Eashanvi/AdaptiveSonar/Figures/Adaptive LFM Sonar Waveform(Deep).png

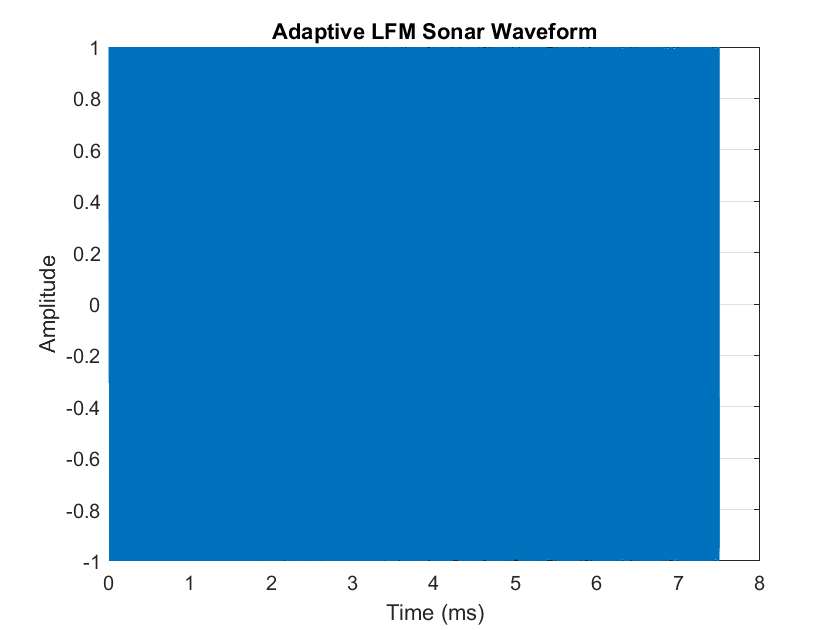
Figures/Adaptive LFM Sonar Waveform(Deep).png
