Eashanvi/AdaptiveSonar/Figures/Adaptive LFM Sonar Waveform(Moderate).png

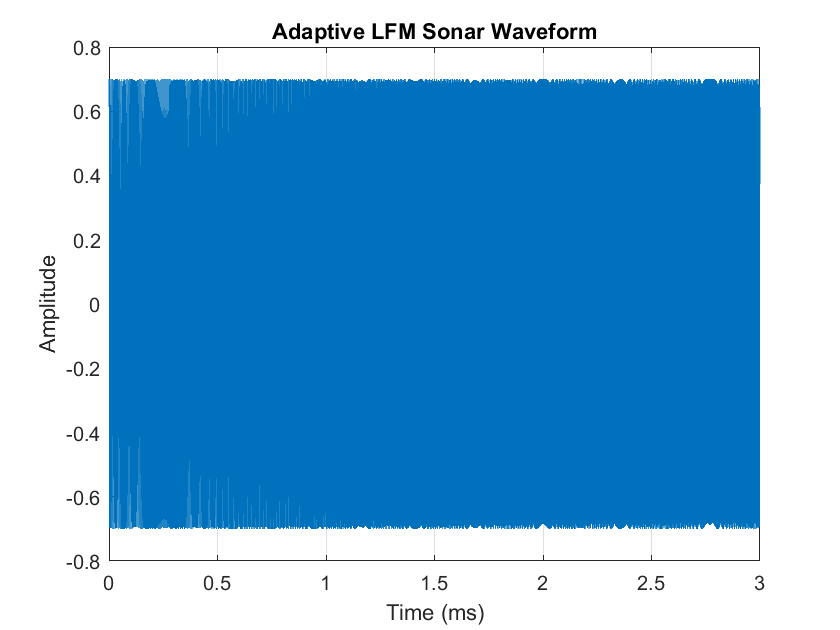
Figures/Adaptive LFM Sonar Waveform(Moderate).png
