Eashanvi/AdaptiveSonar/Figures/Adaptive LFM Sonar Waveform.png

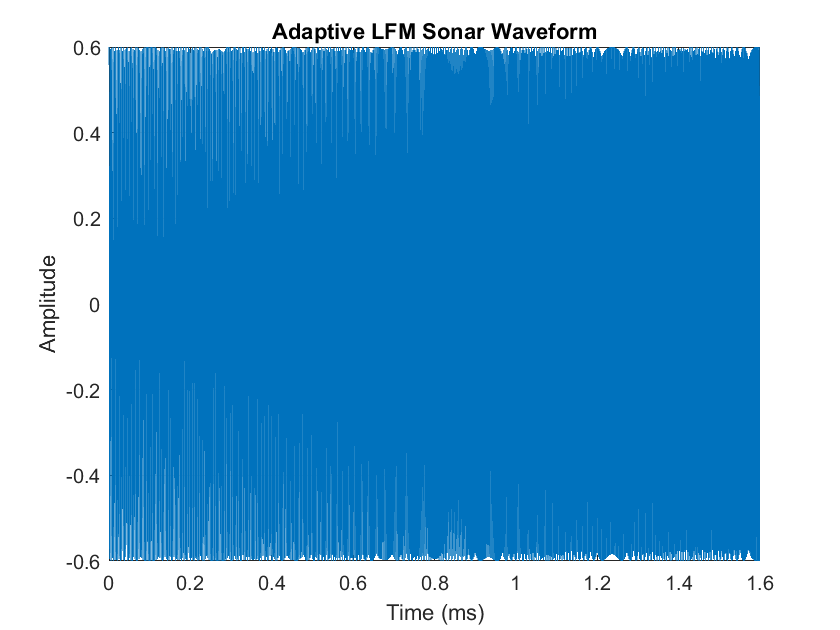
Figures/Adaptive LFM Sonar Waveform.png
