Eashanvi/AdaptiveSonar/Figures/Adaptive Sonar Bandwidth.png

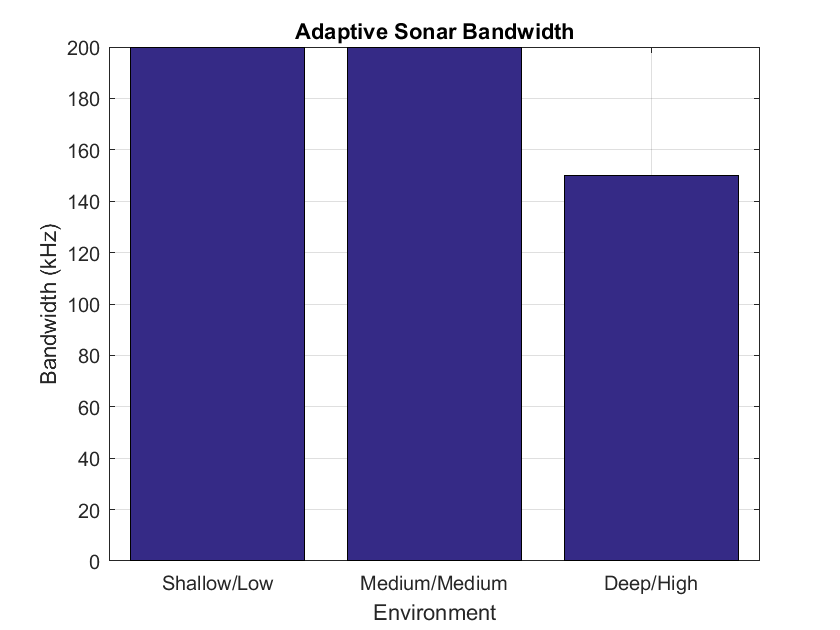
Figures/Adaptive Sonar Bandwidth.png
