Eashanvi/AdaptiveSonar/Figures/Adaptive Sonar Pulse Duration.png

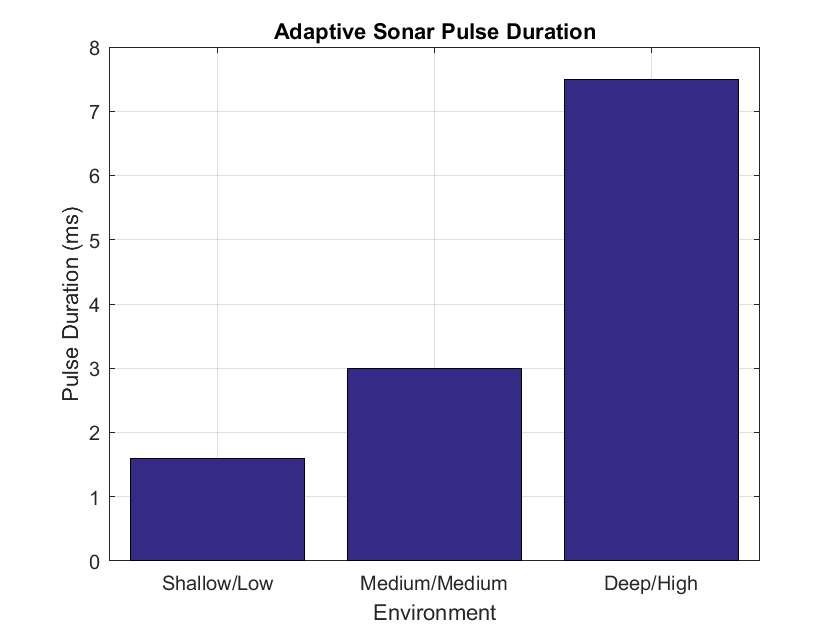
Figures/Adaptive Sonar Pulse Duration.png
