Eashanvi/AdaptiveSonar/Figures/Adaptive Sonar Signal Energy.png

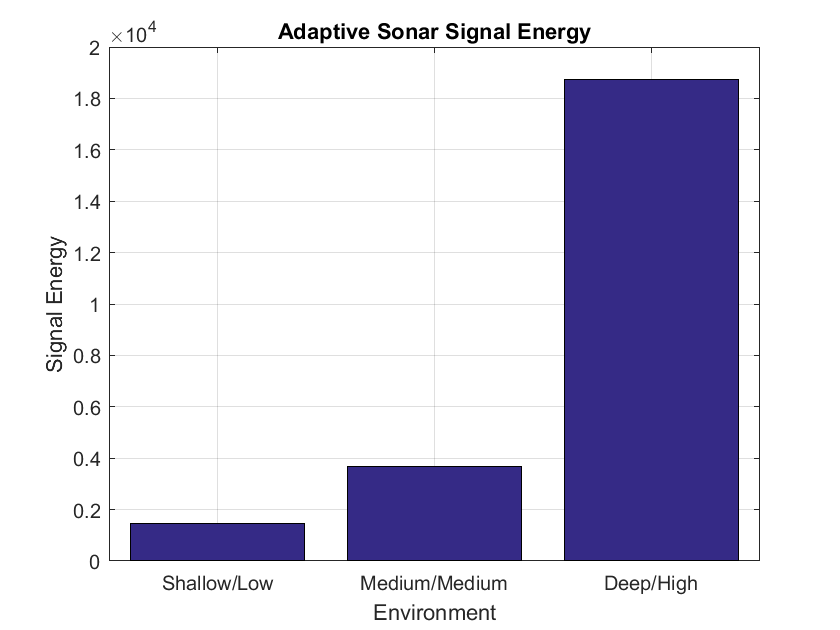
Figures/Adaptive Sonar Signal Energy.png
