Eashanvi/AdaptiveSonar/Figures/Autocorrelation - LFM.png

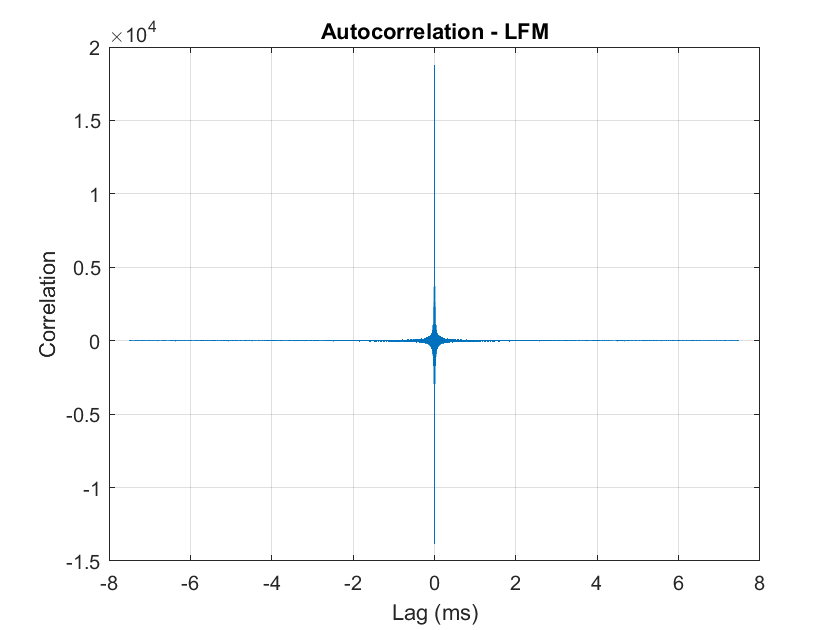
Figures/Autocorrelation - LFM.png
