Eashanvi/AdaptiveSonar/Figures/Barker - 13 Phase Coded Pulse.png

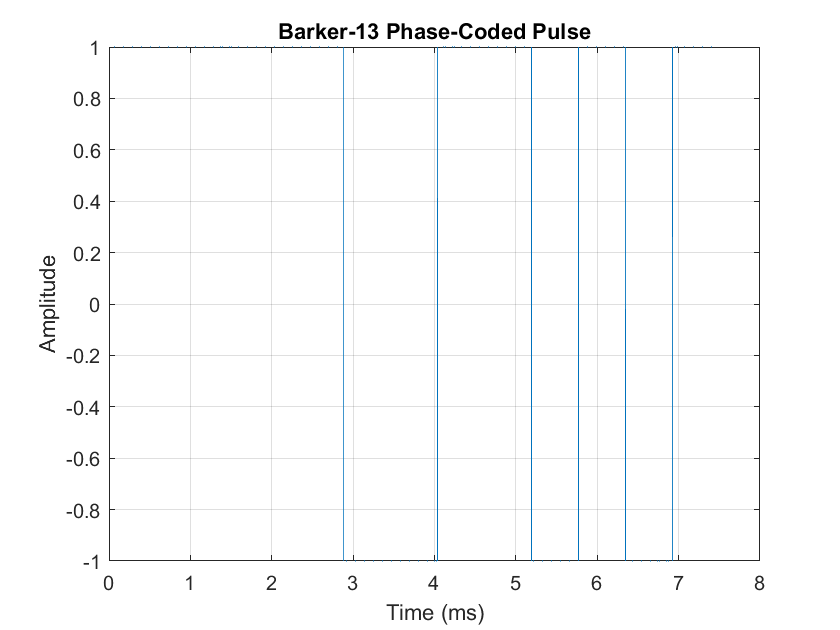
Figures/Barker - 13 Phase Coded Pulse.png
