Eashanvi/AdaptiveSonar/Figures/Geometric Sweep Instantaneous Frequency.png

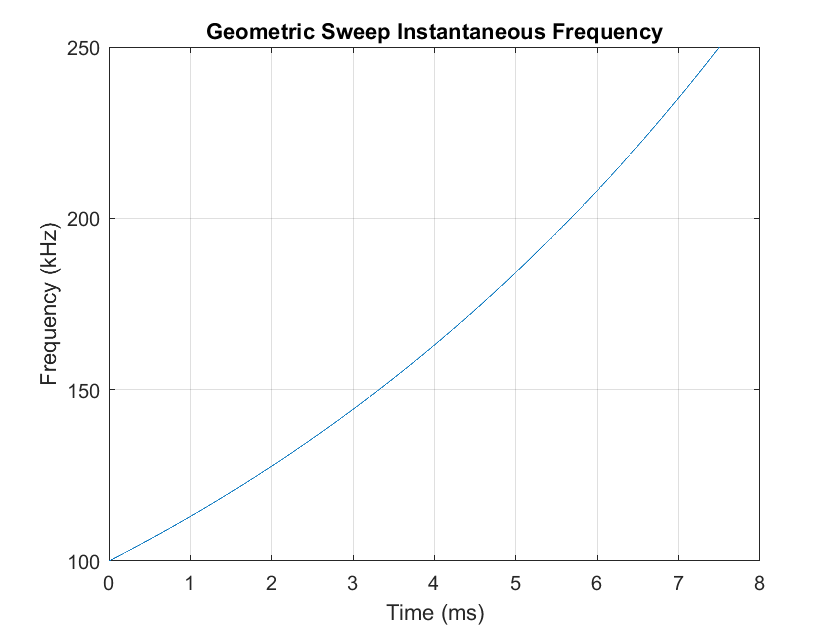
Figures/Geometric Sweep Instantaneous Frequency.png
