Eashanvi/AdaptiveSonar/Figures/LFM Frequency Spectrum.png

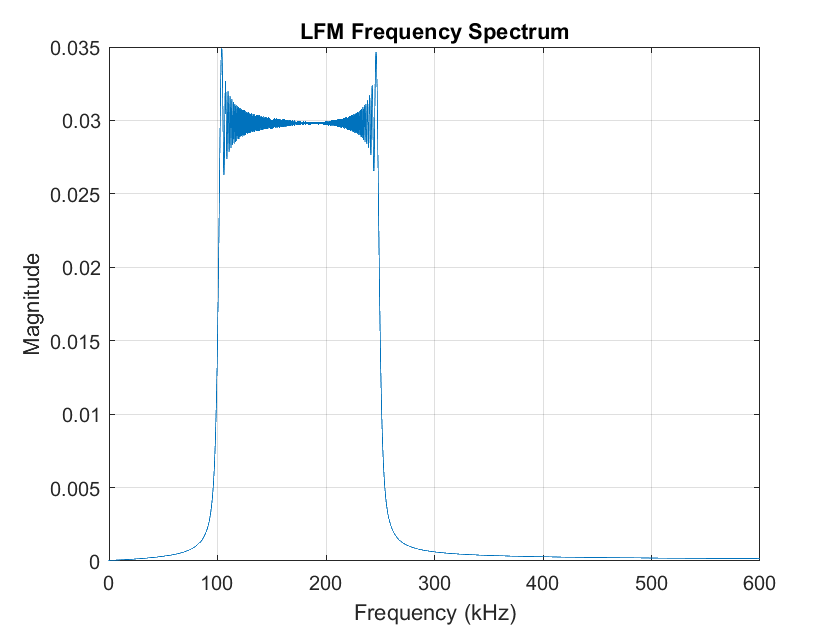
Figures/LFM Frequency Spectrum.png
