Eashanvi/AdaptiveSonar/Figures/LFM Instantaneuos Frequency (Deep ).png

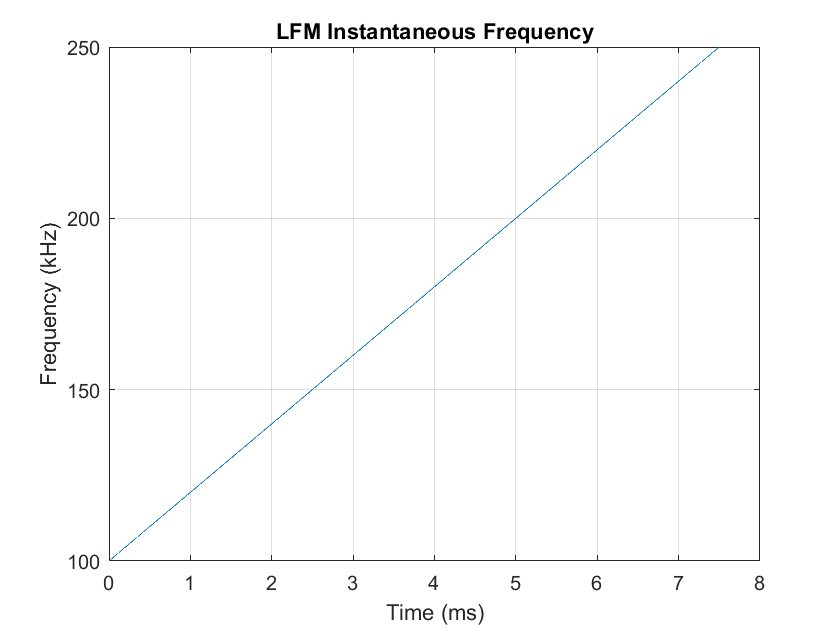
Figures/LFM Instantaneuos Frequency (Deep ).png
