Eashanvi/AdaptiveSonar/Figures/LFM Instantaneuos Frequency (Moderate ).png

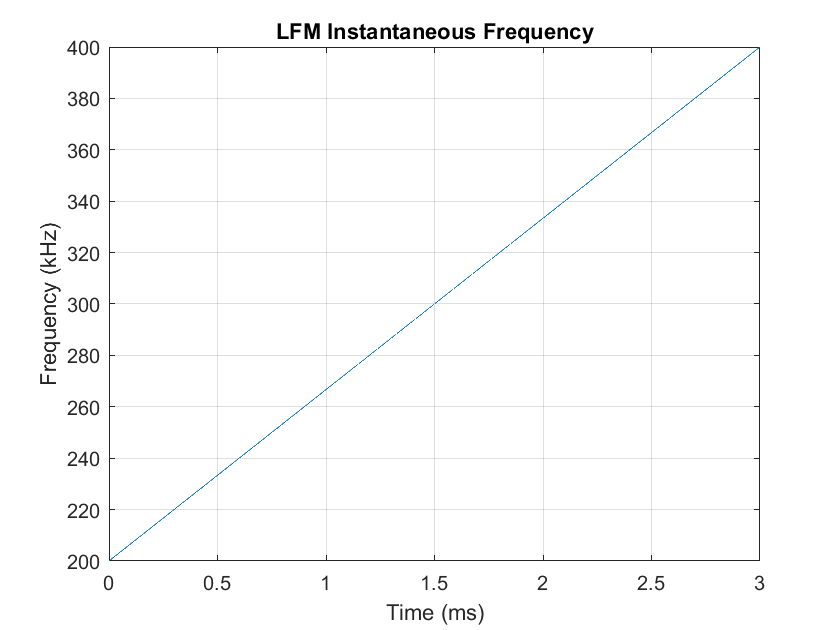
Figures/LFM Instantaneuos Frequency (Moderate ).png
