Eashanvi/AdaptiveSonar/Figures/LFM Instantaneuos Frequency.png

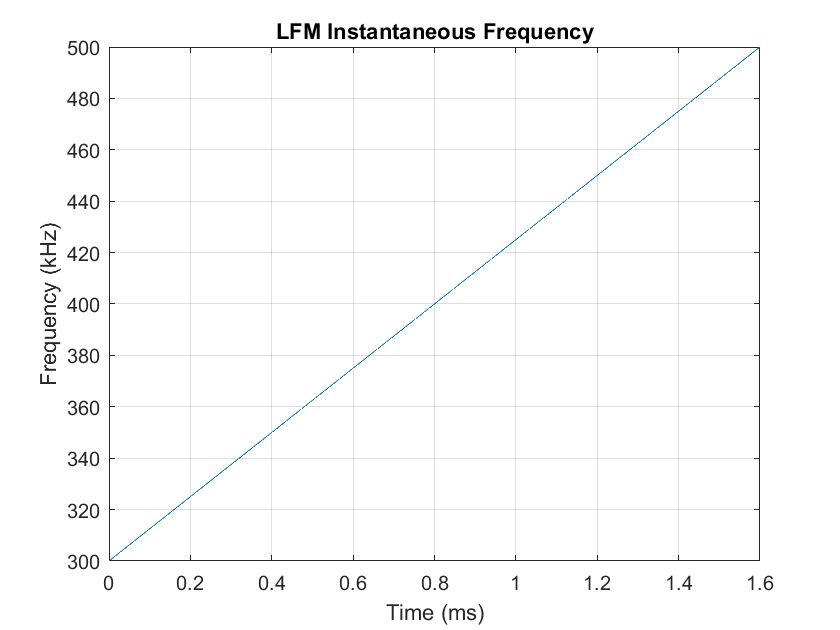
Figures/LFM Instantaneuos Frequency.png
