Eashanvi/AdaptiveSonar/Figures/LFM Sonar Spectogram.png

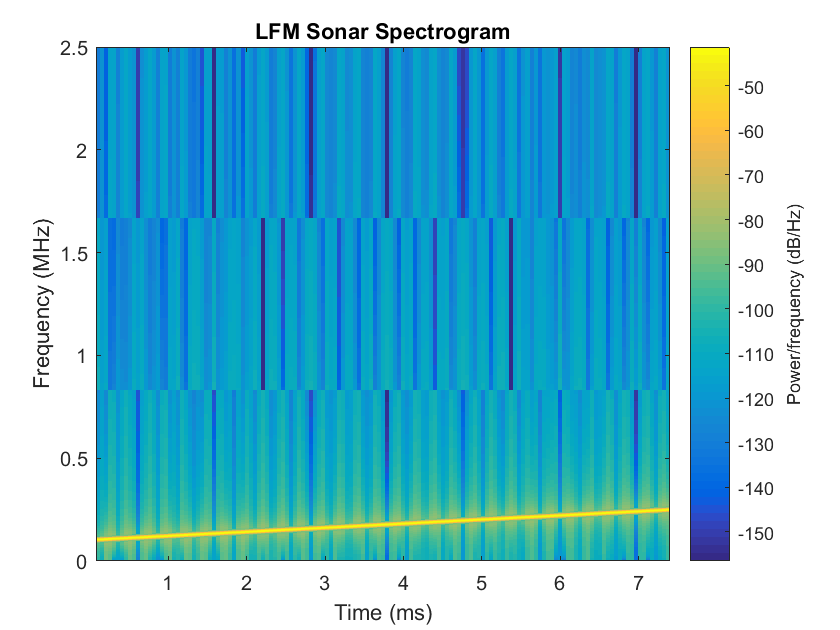
Figures/LFM Sonar Spectogram.png
