Eashanvi/AdaptiveSonar/fpga/simulation/reference_pictures/STEPPED.png

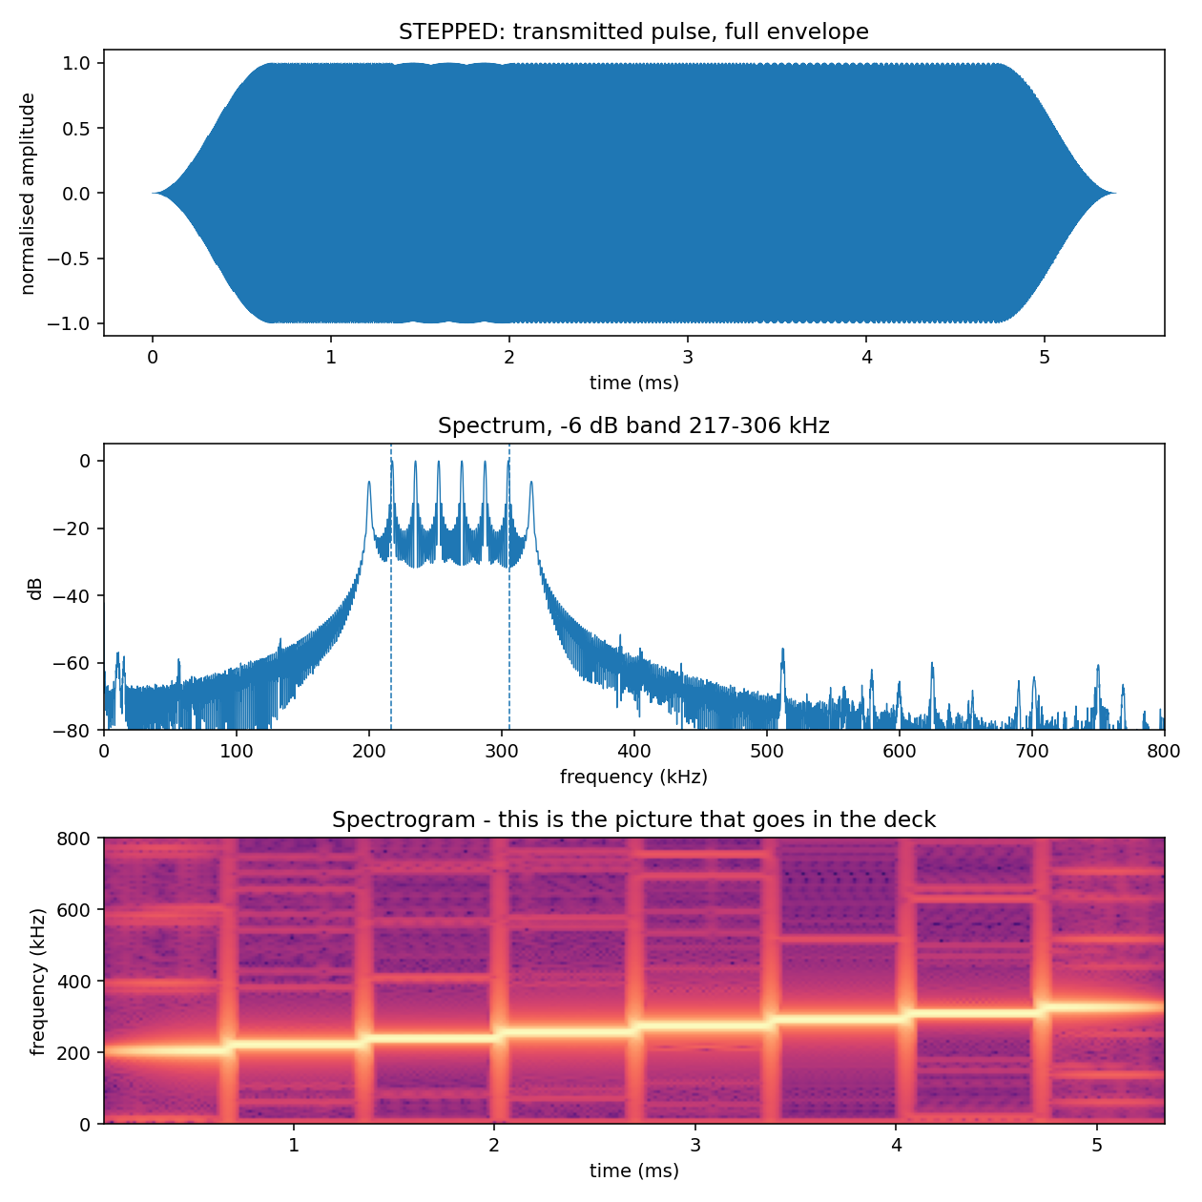
fpga/simulation/reference_pictures/STEPPED.png
