Eashanvi/AdaptiveSonar/firmware/stm32/AdaptiveSonar/AdaptiveSonar.ioc

Mcu.UserName=STM32F407VGTx
PA0-WKUP.Signal=GPIO_Input
PA2.Signal=USART2_TX
PA3.Signal=USART2_RX
PA4.Signal=COMP_DAC1_group
PC1.Signal=ADCx_IN11
PC2.Signal=ADCx_IN12
PC4.Signal=ADCx_IN14
PC5.Signal=ADCx_IN15
PD12.Signal=GPIO_Output
PD13.Signal=GPIO_Output
PD14.Signal=GPIO_Output
PD15.Signal=GPIO_Output
PD2.Signal=GPIO_Output
PH0-OSC_IN.Signal=RCC_OSC_IN
PH1-OSC_OUT.Signal=RCC_OSC_OUT
