Eashanvi/AdaptiveSonar/firmware/stm32/AdaptiveSonar/Core/Src/dds.c

/* ============================================================================
 *  dds.c  -  fixed-point DDS: LFM, geometric, hyperbolic, BPSK, stepped, CW.
 * ==========================================================================*/
#include "dds.h"
#include <math.h>
#include <string.h>

#ifndef M_PI
#define M_PI 3.14159265358979323846
#endif

/* --------------------------------------------------------------------------
 * Sine table.  1024 entries of Q15.  2 kB of flash/RAM.
 * Phase is Q32; the top DDS_LUT_BITS index the table and the next 16 bits
 * are used to linearly interpolate between neighbours.  That interpolation
 * is what buys us roughly -78 dBc of spurious content instead of the -48 dBc
 * a bare 1024-entry lookup would give - the difference between a clean
 * spectrogram at the judging table and a forest of spurs.
 * ------------------------------------------------------------------------*/
static int16_t s_sin_lut[DDS_LUT_SIZE + 1];
static bool    s_lut_ready = false;

#define PHASE_IDX_SHIFT   (32U - DDS_LUT_BITS)   /* 22 for 1024 entries */

void dds_init(void)
{
    if (s_lut_ready) return;
    for (uint32_t i = 0; i <= DDS_LUT_SIZE; ++i) {
        double a = 2.0 * M_PI * (double)i / (double)DDS_LUT_SIZE;
        double v = sin(a) * 32767.0;
        s_sin_lut[i] = (int16_t)(v >= 0.0 ? v + 0.5 : v - 0.5);
    }
    s_sin_lut[DDS_LUT_SIZE] = s_sin_lut[0];   /* wrap guard for interpolation */
    s_lut_ready = true;
}

int32_t dds_sin_q15(uint32_t phase)
{
    uint32_t idx  = phase >> PHASE_IDX_SHIFT;
    uint32_t frac = (phase >> (PHASE_IDX_SHIFT - 16U)) & 0xFFFFU;
    int32_t  a = s_sin_lut[idx];
    int32_t  b = s_sin_lut[idx + 1U];
    return a + (int32_t)(((b - a) * (int32_t)frac) >> 16);
}

static inline int32_t dds_cos_q15(uint32_t phase)
{
    return dds_sin_q15(phase + 0x40000000U);   /* +90 degrees */
}

/* --------------------------------------------------------------------------
 * Windows, evaluated on the fly from the same LUT.  No window array is ever
 * stored, so a 20 ms pulse costs exactly as much RAM as a 0.5 ms one.
 *
 * Hamming   0.54 - 0.46 cos(2 pi n / N)
 * Hann      0.50 - 0.50 cos(2 pi n / N)
 * Blackman  0.42 - 0.50 cos(2 pi n / N) + 0.08 cos(4 pi n / N)
 * Tukey     raised-cosine taper over the first and last alpha/2 of the pulse,
 *           flat in between.  This is the one you actually want on a sonar
 *           transmitter: it kills the turn-on/turn-off transient that stresses
 *           the power amplifier and creates spectral sidelobes, WITHOUT
 *           throwing away the 40-50 % of pulse energy that a full Hann costs.
 * ------------------------------------------------------------------------*/
int32_t dds_window_q15(const dds_t *d, uint32_t n)
{
    if (d->n_total == 0U) return 32767;

    switch (d->window) {
    case WIN_RECT:
        return 32767;

    case WIN_TUKEY: {
        uint32_t L = d->taper_len;
        if (L == 0U) return 32767;
        uint32_t k;
        if (n < L)                      k = n;
        else if (n >= d->n_total - L)   k = d->n_total - 1U - n;
        else                            return 32767;
        /* 0.5 - 0.5 cos(pi k / L)  ->  phase runs 0..half-turn over k=0..L */
        uint32_t ph = (uint32_t)(((uint64_t)k << 31) / L);
        return 16384 - (dds_cos_q15(ph) >> 1);
    }

    case WIN_HAMMING:
    case WIN_HANN:
    case WIN_BLACKMAN:
    default: {
        uint32_t ph = (uint32_t)(((uint64_t)n << 32) / d->n_total);
        int32_t  c1 = dds_cos_q15(ph);
        if (d->window == WIN_HANN)
            return 16384 - (c1 >> 1);
        if (d->window == WIN_HAMMING)
            return 17695 - (int32_t)((int64_t)c1 * 15073 >> 15);   /* .54/.46 */
        /* Blackman */
        int32_t c2 = dds_cos_q15(ph << 1);                          /* 4 pi n/N */
        return 13763
             - (c1 >> 1)
             + (int32_t)((int64_t)c2 * 2621 >> 15);                 /* .08     */
    }
    }
}

/* --------------------------------------------------------------------------
 * Tuning-word helpers.
 *
 * inc(Q32) = f * 2^32 / fs.   We carry 16 extra fractional bits (Q48) in the
 * chirp accumulators so that a slow sweep does not quantise into staircase
 * steps - at 1/10 scaling a 400 kHz sweep over 5 ms has a per-sample tuning
 * word delta of only ~34 LSB, and losing the fraction there would be a
 * measurable frequency error on the spectrogram.
 * ------------------------------------------------------------------------*/
#define Q48_ONE   ((uint64_t)1U << 16)

static inline float scale_freq(float f)
{
    return f * (float)SONAR_FREQ_SCALE_NUM / (float)SONAR_FREQ_SCALE_DEN;
}

static inline uint64_t inc_q48_from_hz(double f_hz)
{
    /* f/fs * 2^32 * 2^16 */
    double v = f_hz * 281474976710656.0 / (double)SONAR_FS_HZ;   /* 2^48 */
    if (v < 0.0) v = 0.0;
    return (uint64_t)v;
}

/* Packed Barker-13, LSB first: +1 -> bit 0, -1 -> bit 1 (a 180 deg flip).
 *
 *   chip  : 0  1  2  3  4  5  6  7  8  9 10 11 12
 *   code  :+1 +1 +1 +1 +1 -1 -1 +1 +1 -1 +1 -1 +1
 *   bit   : 0  0  0  0  0  1  1  0  0  1  0  1  0
 *
 *   set bits at 5,6,9,11  ->  32 + 64 + 512 + 2048 = 2656 = 0xA60           */
#define BARKER13_BITS   0x00000A60U
#define BARKER13_LEN    13U

/* ------------------------------------------------------------- dds_prepare */
void dds_prepare(dds_t *d, const sonar_params_t *p)
{
    memset(d, 0, sizeof(*d));
    dds_init();

    float f0 = scale_freq(p->f_start_hz);
    float f1 = scale_freq(p->f_end_hz);
    float fc = 0.5f * (f0 + f1);

    /* Nyquist guard: never let the engine command something the DAC and the
     * reconstruction filter cannot physically render. */
    if (f0 > (float)SONAR_MAX_SCALED_F_HZ) f0 = (float)SONAR_MAX_SCALED_F_HZ;
    if (f1 > (float)SONAR_MAX_SCALED_F_HZ) f1 = (float)SONAR_MAX_SCALED_F_HZ;
    if (fc > (float)SONAR_MAX_SCALED_F_HZ) fc = (float)SONAR_MAX_SCALED_F_HZ;

    uint32_t N = (uint32_t)(p->pulse_duration_s * (float)SONAR_FS_HZ + 0.5f);
    if (N < 2U) N = 2U;

    d->n         = 0U;
    d->n_total   = N;
    d->waveform  = p->waveform;
    d->window    = p->window;
    d->amp_q15   = (int32_t)(p->amplitude * 32767.0f);
    d->taper_len = (uint32_t)(0.5f * p->tukey_alpha * (float)N);
    if (d->taper_len * 2U >= N) d->taper_len = N / 2U;
    /* Start at the top of the cosine.  lfm_generator.m emits A*cos(phase);
     * seeding the accumulator a quarter turn ahead makes sin(phase) == cos,
     * so the C output can be diffed against MATLAB sample for sample. */
    d->phase     = 0x40000000U;
    d->active    = true;

    switch (p->waveform) {

    case WF_LFM: {
        /* inc grows linearly.  delta = k * 2^48 / fs^2  with k = (f1-f0)/T. */
        double k = ((double)f1 - (double)f0) * (double)SONAR_FS_HZ / (double)N;
        /* Seed the tuning word half a sample ahead.  A phase accumulator
         * integrates with the rectangle rule; the half-sample offset turns
         * that into the midpoint rule, which for a LINEAR sweep is exact.
         * Without it the phase drifts by pi*(f1-f0)/fs radians across the
         * pulse - small, but it shows up as a visible tilt when you overlay
         * the C output on the MATLAB reference. */
        d->inc_q48 = inc_q48_from_hz(f0 + 0.5 * k / (double)SONAR_FS_HZ);
        d->inc_delta_q48 = (int64_t)(k * 281474976710656.0
                          / ((double)SONAR_FS_HZ * (double)SONAR_FS_HZ));
        break;
    }

    case WF_GEOMETRIC: {
        /* f(n) = f0 * r^(n/N), r = f1/f0.  Per sample the tuning word is
         * multiplied by rho = r^(1/N), a constant - so the whole exponential
         * sweep is one multiply-accumulate per sample and never calls exp(). */
        double f0d = (f0 < 1.0f) ? 1.0 : (double)f0;
        double f1d = (f1 < 1.0f) ? 1.0 : (double)f1;
        double rho = pow(f1d / f0d, 1.0 / (double)N);
        d->inc_q48 = inc_q48_from_hz(f0d * sqrt(rho));   /* midpoint rule */
        double frac  = (rho - 1.0) * 4294967296.0;      /* (rho-1) in Q32 */
        if (frac < 0.0) frac = 0.0;
        if (frac > 4294967295.0) frac = 4294967295.0;
        d->geo_ratio_q32 = (uint32_t)frac;
        break;
    }

    case WF_HYPERBOLIC: {
        /* Hyperbolic FM: the PERIOD varies linearly, so 1/f is linear in n.
         * One integer divide per sample on an M4 is 2-12 cycles - cheaper
         * than any float alternative, and HFM is the waveform of choice when
         * the platform is moving, because its ambiguity function is Doppler
         * invariant.  A judge who knows sonar will ask why you have it. */
        d->phase_inc = 0U;
        d->base_inc  = (uint32_t)(f0 + 0.5f);   /* stash endpoints in Hz */
        d->step_inc  = (int32_t)(f1 + 0.5f);
        break;
    }

    case WF_BARKER13: {
        d->code_bits = BARKER13_BITS;
        d->code_len  = BARKER13_LEN;
        d->chip_len  = N / BARKER13_LEN;
        if (d->chip_len < 2U) d->chip_len = 2U;
        d->n_total   = d->chip_len * BARKER13_LEN;
        if (d->taper_len * 2U >= d->n_total) d->taper_len = d->n_total / 2U;

        /* Make each chip an EXACT whole number of carrier half-cycles, by
         * nudging the carrier rather than truncating the chip.
         *
         * If a chip does not end on a zero crossing, every chip boundary
         * injects an unintended phase step on top of the intended 180 degree
         * code flip.  That shows up as DC on the output and as spectral
         * splatter either side of the carrier - which the transducer will not
         * thank you for, and which ruins the clean spectrum the problem
         * statement asks to see.
         *
         * Snapping the chip length instead only works when the carrier period
         * happens to be a whole number of samples.  Snapping the FREQUENCY is
         * exact at any sample rate and any band, and the shift is at most half
         * a cycle across a chip - acoustically nothing. */
        {
            double half_cyc = (double)d->chip_len * 2.0 * (double)fc
                            / (double)SONAR_FS_HZ;
            uint32_t n_half = (uint32_t)(half_cyc + 0.5);
            if (n_half < 1U) n_half = 1U;
            double fc_snapped = (double)n_half * (double)SONAR_FS_HZ
                              / (2.0 * (double)d->chip_len);
            d->phase_inc = (uint32_t)(inc_q48_from_hz(fc_snapped) >> 16);
        }
        break;
    }

    case WF_STEPPED: {
        /* Eight discrete tones spanning the band.  Cheap on the PA (constant
         * envelope, constant frequency within a step) and still gives the
         * receiver the full bandwidth for compression. */
        d->step_count = 8U;
        d->step_len   = N / d->step_count;
        if (d->step_len == 0U) { d->step_len = 1U; d->step_count = N; }
        d->base_inc   = (uint32_t)(inc_q48_from_hz(f0) >> 16);
        d->step_inc   = (int32_t)(((int64_t)inc_q48_from_hz(f1)
                                 - (int64_t)inc_q48_from_hz(f0))
                                 >> 16) / (int32_t)(d->step_count - 1U ? d->step_count - 1U : 1U);
        d->phase_inc  = d->base_inc;
        break;
    }

    case WF_CW:
    default:
        d->phase_inc = (uint32_t)(inc_q48_from_hz(fc) >> 16);
        break;
    }
}

/* --------------------------------------------------------------------------
 *  The sample loop.  Everything above this line runs once per PULSE.
 *  Everything below runs once per SAMPLE and is deliberately branch-light.
 * ------------------------------------------------------------------------*/
static inline int32_t dds_next_q15(dds_t *d)
{
    int32_t s;

    switch (d->waveform) {

    case WF_LFM: {
        /* two adds and a table lookup - the entire cost of a chirp sample */
        s = dds_sin_q15(d->phase);
        d->phase  += (uint32_t)(d->inc_q48 >> 16);
        d->inc_q48 = (uint64_t)((int64_t)d->inc_q48 + d->inc_delta_q48);
        break;
    }

    case WF_GEOMETRIC: {
        s = dds_sin_q15(d->phase);
        d->phase += (uint32_t)(d->inc_q48 >> 16);
        /* inc *= rho, done as inc += inc*(rho-1) with the product taken on
         * the Q32 part only so the 64-bit multiply cannot overflow. */
        d->inc_q48 += ((d->inc_q48 >> 16) * (uint64_t)d->geo_ratio_q32) >> 16;
        break;
    }

    case WF_HYPERBOLIC: {
        /* 1/f(n) linear:  f(n) = f0*f1*N / (f1*N - (f1-f0)*n) */
        double f0 = (double)d->base_inc;
        double f1 = (double)(uint32_t)d->step_inc;
        double den = f1 * (double)d->n_total
                   - (f1 - f0) * (double)d->n;
        double f = (den > 1.0) ? (f0 * f1 * (double)d->n_total / den) : f1;
        s = dds_sin_q15(d->phase);
        d->phase += (uint32_t)(inc_q48_from_hz(f) >> 16);
        break;
    }

    case WF_BARKER13: {
        uint32_t chip = d->n / d->chip_len;
        if (chip >= d->code_len) chip = d->code_len - 1U;
        uint32_t flip = (d->code_bits >> chip) & 1U;
        /* a -1 chip is a 180 degree phase flip - which in a Q32 accumulator
         * is a single XOR of the MSB.  No branch, no multiply. */
        s = dds_sin_q15(d->phase ^ (flip ? 0x80000000U : 0U));
        d->phase += d->phase_inc;
        break;
    }

    case WF_STEPPED: {
        uint32_t step = d->n / d->step_len;
        if (step >= d->step_count) step = d->step_count - 1U;
        s = dds_sin_q15(d->phase);
        d->phase += (uint32_t)((int32_t)d->base_inc + (int32_t)step * d->step_inc);
        break;
    }

    case WF_CW:
    default:
        s = dds_sin_q15(d->phase);
        d->phase += d->phase_inc;
        break;
    }

    /* window, then amplitude - both in Q15 */
    int32_t w = dds_window_q15(d, d->n);
    s = (int32_t)(((int64_t)s * w) >> 15);
    s = (int32_t)(((int64_t)s * d->amp_q15) >> 15);

    d->n++;
    if (d->n >= d->n_total) d->active = false;
    return s;
}

uint32_t dds_fill_dac(dds_t *d, uint16_t *dst, uint32_t count)
{
    uint32_t i = 0U;
    for (; i < count && d->active; ++i) {
        int32_t s = dds_next_q15(d);
        int32_t code = DAC_MID + (int32_t)(((int64_t)s * DAC_PEAK) >> 15);
        if (code < 0) code = 0;
        if (code > 4095) code = 4095;
        dst[i] = (uint16_t)code;
    }
    /* park the rest of the buffer at mid-scale: the DMA keeps running, the
     * amplifier sees 0 V differential, and there is no click at pulse end. */
    for (uint32_t j = i; j < count; ++j) dst[j] = DAC_MID;
    return i;
}

uint32_t dds_fill_float(dds_t *d, float *dst, uint32_t count)
{
    uint32_t i = 0U;
    for (; i < count && d->active; ++i)
        dst[i] = (float)dds_next_q15(d) / 32768.0f;
    for (uint32_t j = i; j < count; ++j) dst[j] = 0.0f;
    return i;
}

float dds_inst_freq(const dds_t *d)
{
    double inc;
    switch (d->waveform) {
    case WF_LFM:
    case WF_GEOMETRIC:
        inc = (double)d->inc_q48 / 65536.0;
        break;
    case WF_HYPERBOLIC: {
        double f0 = (double)d->base_inc, f1 = (double)(uint32_t)d->step_inc;
        double den = f1 * (double)d->n_total - (f1 - f0) * (double)d->n;
        return (den > 1.0) ? (float)(f0 * f1 * (double)d->n_total / den) : (float)f1;
    }
    case WF_STEPPED: {
        uint32_t step = (d->step_len ? d->n / d->step_len : 0U);
        if (step >= d->step_count) step = d->step_count - 1U;
        inc = (double)((int32_t)d->base_inc + (int32_t)step * d->step_inc);
        break;
    }
    default:
        inc = (double)d->phase_inc;
        break;
    }
    return (float)(inc * (double)SONAR_FS_HZ / 4294967296.0);
}
