Eashanvi/AdaptiveSonar/firmware/stm32/AdaptiveSonar/Core/Inc/environment.h

/* ============================================================================
 *  environment.h  -  sensor conditioning + the underwater acoustics that the
 *                    MATLAB model left on the table.
 *
 *  environment_model.m stored temperature and salinity into a struct and then
 *  never read them again.  Every decision was driven by depth and turbidity
 *  alone.  That is fine for a first proof of concept and it is the single
 *  most obvious thing for a judge to poke at.
 *
 *  Here temperature and salinity do real work.  They set the speed of sound
 *  (Mackenzie 1981), which is what converts a bandwidth into a range
 *  resolution and a pulse repetition interval into a maximum range.  Together
 *  with depth they set the absorption coefficient (Francois & Garrison 1982),
 *  which is what tells you the highest frequency worth transmitting at all.
 *  Those two numbers are the physics behind the entire adaptation decision.
 * ==========================================================================*/
#ifndef ENVIRONMENT_H
#define ENVIRONMENT_H

#include "sonar_types.h"
#include "sonar_config.h"

/* Reset filters and hysteresis state.  Call once at boot. */
void env_init(void);

/* Convert four raw ADC counts (0..4095) into engineering units, low-pass
 * filter them, classify with hysteresis, and compute the derived acoustics.
 * `raw` order: depth, turbidity, temperature, salinity. */
void env_update_from_adc(sonar_env_t *env, const uint16_t raw[ENV_ADC_CHANNELS]);

/* Same, but from engineering units directly - used by the host simulator and
 * by the MATLAB cross-check so the numbers are comparable. */
void env_update(sonar_env_t *env,
                float depth_m, float turbidity_pct,
                float temperature_c, float salinity_psu);

/* --- the physics, exposed so they can be unit-tested and plotted --------- */

/* Mackenzie (1981) nine-term equation, valid 0-30 C, 25-40 ppt, 0-8000 m. */
float env_sound_speed(float temp_c, float sal_psu, float depth_m);

/* Francois & Garrison (1982) total absorption in dB/km, plus an empirical
 * suspended-sediment scattering term driven by turbidity. */
float env_absorption_db_km(float f_hz, float temp_c, float sal_psu,
                           float depth_m, float turbidity_pct);

/* Highest frequency whose two-way transmission loss over `range_m` still
 * fits inside `budget_db`.  This is what actually caps the sweep. */
float env_max_useful_freq(const sonar_env_t *e, float range_m, float budget_db);

const char *env_depth_name(depth_state_t s);
const char *env_turb_name(turbidity_state_t s);

#endif /* ENVIRONMENT_H */
