Eashanvi/AdaptiveSonar/(commit log)

2026-10-19 Add STM32 firmware v3.1 and DE1-SoC FPGA design
2026-10-19 Update README: STM32, FPGA, sensor board and pod sections with photos
